uehashu/HHKBLite2BT/FlowChart.pdf

HHKBLite2BT - Flowchart

キーステートを送信
バッテリーチェック

メモリされてる機器につながっている
and
リセットステートがオフ

Yes

リセットステートがオン No

メモリをクリア

No

Yes
