uehashu/HHKBLite2BT/eagle/HHKBLite2BTforArduinoProMicro33.brd

## EAGLE design eagle/HHKBLite2BTforArduinoProMicro33.brd (2016-02-11)

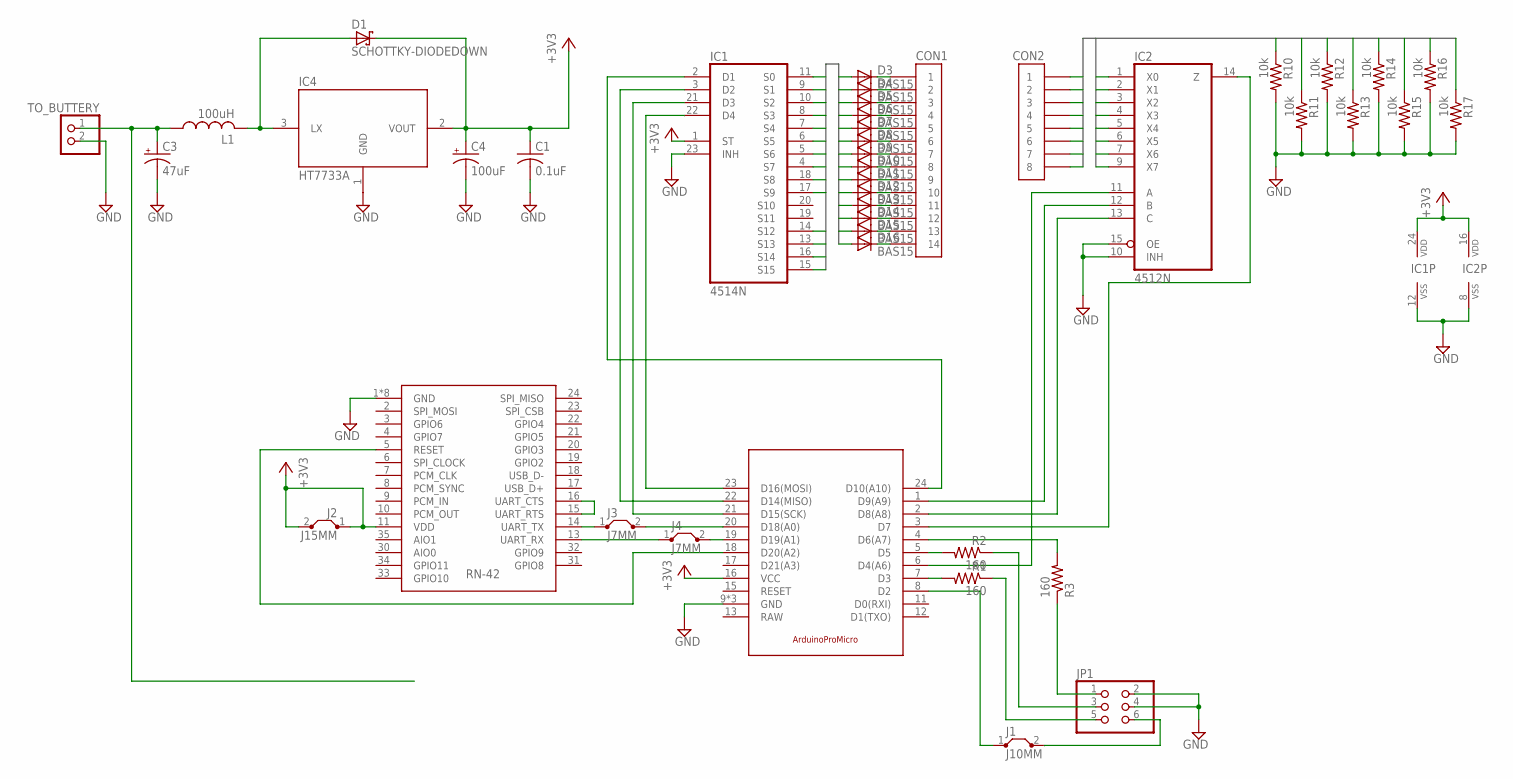
[picture p1: schematic HHKBLite2BTforArduinoProMicro33.sch]

Parts:
C1: 0.1uF; C050-024X044
C3: 47uF; E2,5-7
C4: 100uF; E2,5-7
CON1: 45045-1445; 52045-1445
CON2: 45045-0845; 52045-0845
D1: SCHOTTKY-DIODEDOWN; DIODE-STAND-DOWN
D3, D4, D5, D6, D7, D8, D9, D10, D11, D12, D13, D14, D15, D16: BAS15; DO34-7
IC1: 4514N; DIL24-6
IC2: 4512N; DIL16
IC4: HT7733A; TO-92
J1: J10MM; 10
J2: J15MM; 15
J3, J4: J7MM; 07
JP1: PINHD-2X3/90; 2X03/90
L1: 100uH; E5-10
R1, R2: 160; 0207/7
R3: 160; 0207/10
R10, R11, R12, R14, R15, R16, R17: 10k; 0207/7
R13: 10k; 0207/10
TO_BUTTERY: PINHD-1X2; 1X02
U$1: RN-42
U$2: ARDUINO_PRO_MICRO

Connections:
+3V3: C1.1, C4.+, D1.C, IC1.1 (ST), IC1.24 (VDD), IC2.16 (VDD), IC4.2 (VOUT), J2.1, J2.2, U$1.11 (VDD), U$2.16 (VCC)
CON1BUS_O0: D3.A, IC1.11 (S0)
CON1BUS_O1: D5.A, IC1.9 (S1)
CON1BUS_O2: D4.A, IC1.10 (S2)
CON1BUS_O3: D6.A, IC1.8 (S3)
CON1BUS_O4: D7.A, IC1.7 (S4)
CON1BUS_O5: D8.A, IC1.6 (S5)
CON1BUS_O6: D9.A, IC1.5 (S6)
CON1BUS_O7: D10.A, IC1.4 (S7)
CON1BUS_O8: D11.A, IC1.18 (S8)
CON1BUS_O9: D16.A, IC1.17 (S9)
CON1BUS_O12: D13.A, IC1.14 (S12)
CON1BUS_O13: D12.A, IC1.13 (S13)
CON1BUS_O14: D15.A, IC1.16 (S14)
CON1BUS_O15: D14.A, IC1.15 (S15)
CON2BUS_D0: CON2.8, IC2.1 (X0), R10.1
CON2BUS_D1: CON2.7, IC2.2 (X1), R11.1
CON2BUS_D2: CON2.6, IC2.3 (X2), R12.1
CON2BUS_D3: CON2.5, IC2.4 (X3), R13.1
CON2BUS_D4: CON2.4, IC2.5 (X4), R14.1
CON2BUS_D5: CON2.3, IC2.6 (X5), R15.1
CON2BUS_D6: CON2.2, IC2.7 (X6), R16.1
CON2BUS_D7: CON2.1, IC2.9 (X7), R17.1
GND: C1.2, C3.-, C4.-, IC1.12 (VSS), IC1.23 (INH), IC2.8 (VSS), IC2.10 (INH), IC2.15 (OE), IC4.1 (GND), JP1.2, JP1.4, R10.2, R11.2, R12.2, R13.2, R14.2, R15.2, R16.2, R17.2, TO_BUTTERY.2, U$1.1 (GND), U$1.12 (GND), U$1.28 (GND), U$1.29 (GND), U$1.GND1 (GND), U$1.GND2 (GND), U$1.GND3 (GND), U$1.GND4 (GND), U$2.9 (GND), U$2.10 (GND), U$2.14 (GND)
unnamed: R3.2, U$2.4 (D6(A7))
unnamed: R1.2, U$2.7 (D3)
unnamed: D1.A, IC4.3 (LX), L1.+1 (2)
unnamed: R2.2, U$2.5 (D5)
unnamed: J3.1, U$1.14 (UART_TX)
unnamed: U$1.5 (RESET), U$2.18 (D20(A2))
unnamed: J3.2, U$2.20 (D18(A0))
unnamed: JP1.1, R3.1
unnamed: IC2.14 (Z), U$2.3 (D7)
unnamed: JP1.3, R2.1
unnamed: JP1.5, R1.1
unnamed: J1.2, JP1.6
unnamed: J1.1, U$2.8 (D2)
unnamed: J4.1, U$1.13 (UART_RX)
unnamed: IC2.12 (B), U$2.1 (D9(A9))
unnamed: IC2.13 (C), U$2.2 (D8(A8))
unnamed: J4.2, U$2.19 (D19(A1))
unnamed: U$1.15 (UART_RTS), U$1.16 (UART_CTS)
unnamed: IC2.11 (A), U$2.6 (D4(A6))
unnamed: IC1.2 (D1), U$2.24 (D10(A10))
unnamed: IC1.3 (D2), U$2.22 (D14(MISO))
unnamed: IC1.21 (D3), U$2.21 (D15(SCK))
unnamed: IC1.22 (D4), U$2.23 (D16(MOSI))
unnamed: CON1.1, D3.C
unnamed: CON1.2, D4.C
unnamed: CON1.3, D5.C
unnamed: CON1.4, D6.C
unnamed: CON1.5, D7.C
unnamed: CON1.6, D8.C
unnamed: CON1.7, D9.C
unnamed: CON1.8, D10.C
unnamed: CON1.9, D11.C
unnamed: CON1.10, D12.C
unnamed: CON1.11, D13.C
unnamed: CON1.12, D14.C
unnamed: CON1.13, D15.C
unnamed: CON1.14, D16.C
VCC_SRC: C3.+, L1.+ (1), TO_BUTTERY.1

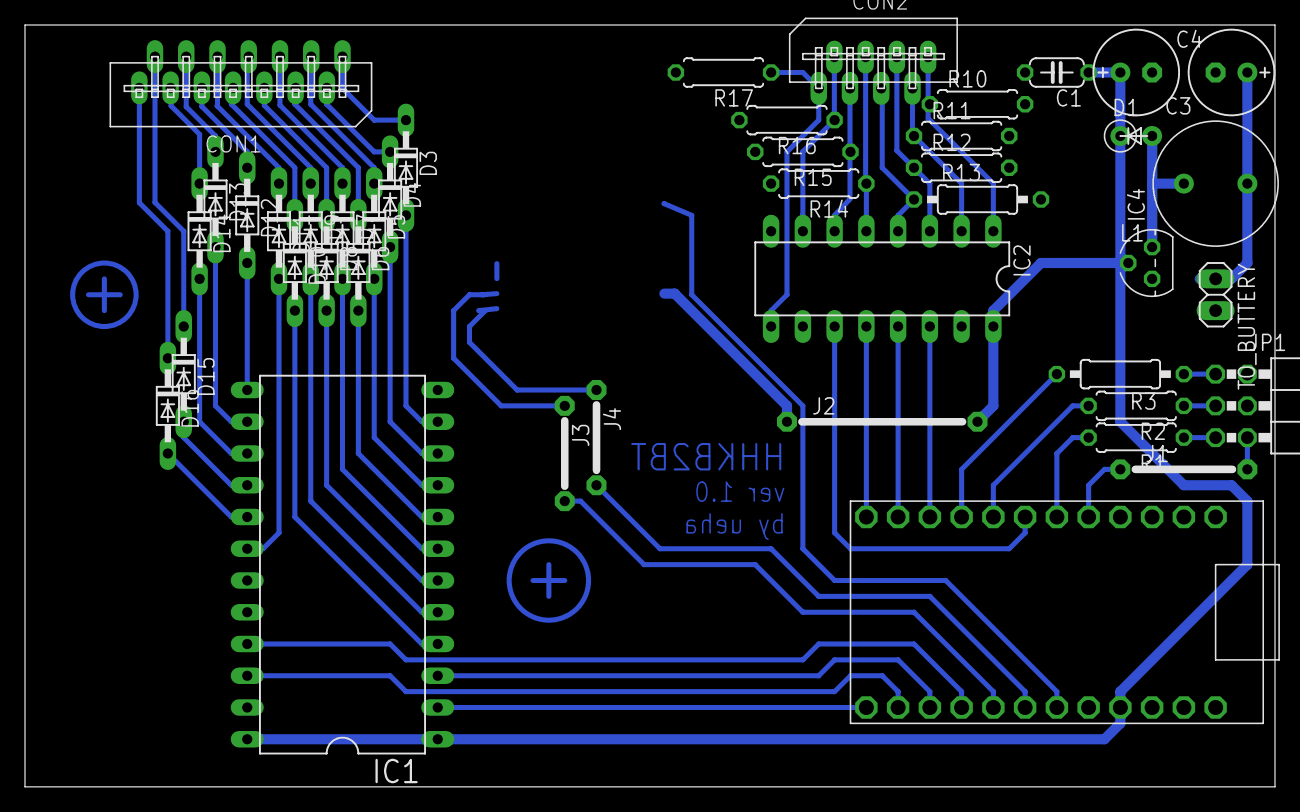
[picture p2: board HHKBLite2BTforArduinoProMicro33.brd from above]

Board: 2 copper layers, 100.0 x 61.0 mm, 43 parts (1 on the bottom side), 62 nets.
