uehashu/HHKBLite2BT/(commit log)

2014-04-09 Initial commit.
    [HHKBLite2BT.sch, HHKBLite2BTwithoutArduinoFTDI.sch, HHKBLite2KeyMatrix-fn.csv, HHKBLite2KeyMatrix-plain.csv]
2014-05-04 基板を作成。
    これまでは Arduino のpin1からpinNまでを順番につないでいたが、
    基板に起こしやすいよう、接続の順番を基板用に書き換えた。
    加えて、基板を作成した。
    [HHKBLite2BT.sch, HHKBLite2BTwithoutArduinoFTDI.brd, HHKBLite2BTwithoutArduinoFTDI.sch, HHKBLite2KeyMatrix-fn.csv, HHKBLite2KeyMatrix-plain.csv]
2014-08-20 Arduino Pro Micro33 を用いた回路図を追加.
    [HHKBLite2BTforArduinoProMicro33.brd, HHKBLite2BTforArduinoProMicro33.sch]
2014-08-24 いろいろ変えた
    回路図については, 電源周りとかアライメントとかを調節した.
    また, パーツのサイズを, 実際に使いそうなサイズにフィットさせた.
    プログラムは移動させた.
    [HHKBLite2BTforArduinoProMicro33.brd, HHKBLite2BTforArduinoProMicro33.sch]
2014-09-02 ProMicro33用コードと回路図を変更
    各ICとのピンの番号が整合するように調節した.
    [DRILEGEND.CFG, HHKBLite2BTforArduinoProMicro33.brd, HHKBLite2BTforArduinoProMicro33.sch]
2014-09-03 コメントとかを修正
    三単現のs付いてなかったし, sweep を sweap と typo してた...
    [HHKBLite2BT.ino]
2014-09-08 入力ピンをINPUTからINPUT_PULLUPに変更
    内部プルアップ抵抗を使うように書き換えた.
    それに伴い, 該当箇所の真理値を逆転させた.
    [HHKBLite2BTforArduinoProMicro33.brd, HHKBLite2BTforArduinoProMicro33.sch]
2014-09-08 フローチャートの追加と, 適切なアルゴリズムへの変更
    ちゃんと動作させるために, フローチャートを作成した.
    そのアルゴリズムに則り, スケッチを変更してある.
    ピン番号や基板はまだ修正していないので注意してほしいよ.
    [HHKBLite2BT.ino]
2015-04-22 Arduino IDE 1.6.x のためにいろいろ変更.
    Arduino IDE 1.6.x と Arduino-Makefile でこのプロジェクトをコンパイルできるように
    するために, いろいろいじった.
    まだ試験的なものなので, 今回変更した Makefile を参考にし, 他のものも
    書き換えると良い.
    あと, ProMicro33 に関して言えば, これをそのまま使ってもコンパイルできない.
    SparkFun から適切なボードコンフィグを持ってきて, 適切な場所に置き,
    適切に Makefile を書き換える必要がある.
    [HHKBLite2BTforArduinoProMicro33.brd, HHKBLite2BTforArduinoProMicro33.sch]
2016-02-11 Arduino IDE v1.6.7 および SparkFun Arduino Library v1.1.3 に対応
    知らぬ間にいろいろバージョンが上がってたみたいで, Arduino.mk とソースコードが
    動かなくなっていた.
    動くように適切に修正したっぽ.
    Arduino.mk は OS X に特化させたので, Linux では動かなくなっているはず.
    [HHKBLite2BT.ino]
2016-02-11 Uno 用のテストコードも Arduino IDE 1.6.7 に追従.
